BaconA7X/DriveCost/(commit log)

2026-09-28 Funcionando la conexion CAN, la lectura GPS y el envio al broker MQTT
    [esp32.ino, nano_coche.ino]
2026-09-28 Revise README for clarity and project updates
    Update README with project details and current status.
2026-10-07 Añade flow de Node-RED y documentación
2026-10-07 Flujos y diseño de MQTT
